sarrchri/6a13tt-timing-tool/6a13tt-timing-gear-tool-gt8-5mm.3mf

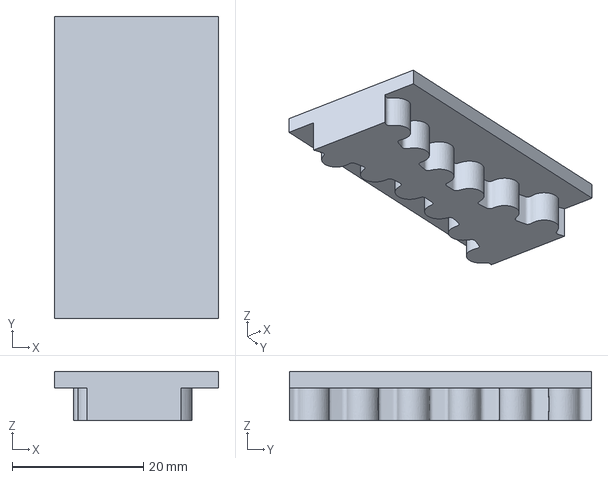
[picture p1: CAD file, 2026-09-26]
6a13tt-timing-gear-tool-gt8-5mm.3mf
25.0 x 46.0 x 7.50 mm
