sarrchri/6a13tt-timing-tool/6a13tt-timing-gears-and-tool-gt8.FCStd

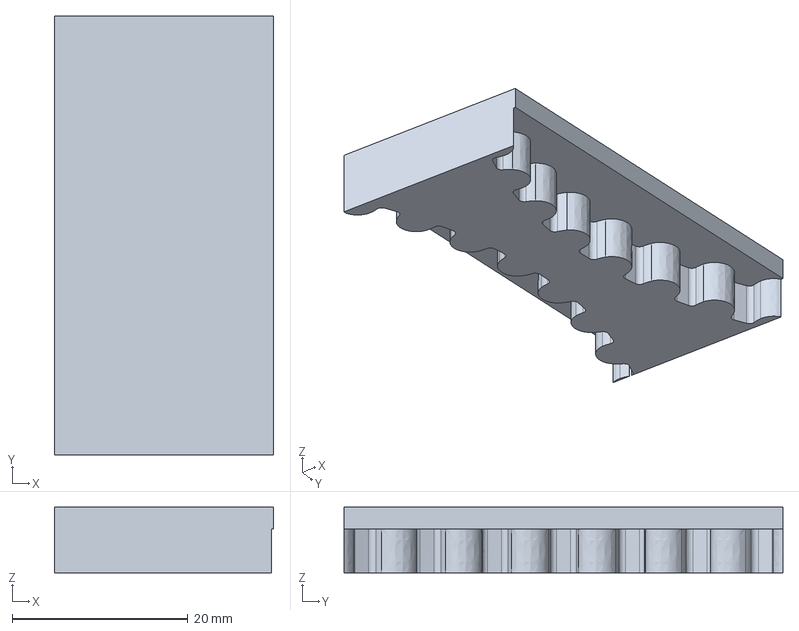
[picture p2: CAD file, 2026-09-22]
6a13tt-timing-gears-and-tool-gt8.FCStd
25.0 x 50.0 x 7.50 mm
