sarrchri/6a13tt-timing-tool/6a13tt-timing-gear-TimingGear-gt8.3mf

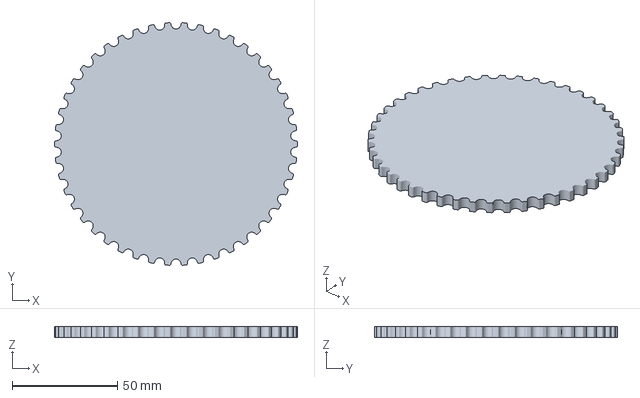
[picture p3: CAD file, 2026-09-20]
6a13tt-timing-gear-TimingGear-gt8.3mf
115.3 x 115.1 x 5.00 mm
