sarrchri/6a13tt-timing-tool/(list of files, cad)

Other CAD files:
6a13tt-timing-gears-and-tool-gt8-5mm.FCStd
6a13tt-timing-gear-tool-gt8-6mm.3mf
6a13tt-timing-gears-and-tool-gt8-6mm.FCStd
6a13tt-timing-gear-tool-gt8.3mf
6a13tt-timing-gear.FCStd
6a13tt-timing-gear-tool.3mf
6a13tt-timing-gear-TimingGear.3mf
