sarrchri/6a13tt-timing-tool/(commit log)

2026-09-19 Upload a rough model of a camshaft gear.
    Need to 3D-print this and compare, then make any adjustments and recompare.
    After the gear is correct, it's then time to make the gear wedge tool.
    [6a13tt-timing-gear.FCStd]
2026-09-19 Another update
    [6a13tt-timing-gear.FCStd]
2026-09-19 Made cross-section cut.
    [6a13tt-timing-gear.FCStd]
2026-09-19 Tool cutout made.
    [6a13tt-timing-gear-tool.3mf, 6a13tt-timing-gear.FCStd]
2026-09-20 Update. Added GT8 tooth profile variant.
    This seems to fit slightly better, but not fully.
    Apparently the tooth profile might a "YU" -profile, which I am not familiar with.
    [6a13tt-timing-gear-TimingGear-gt8.3mf, 6a13tt-timing-gear-tool-gt8.3mf, 6a13tt-timing-gears-and-tool-gt8.FCStd]
2026-09-20 Readjust gear distance for gt8 profile.
    New gear diameter 115.3mm, spacing 6.7mm.
    Will reprint and test fit again.
    [6a13tt-timing-gear-tool-gt8.3mf, 6a13tt-timing-gears-and-tool-gt8.FCStd]
2026-09-22 Set gap to 6mm and generate new project file.
    [6a13tt-timing-gear-tool-gt8-6mm.3mf, 6a13tt-timing-gears-and-tool-gt8-6mm.FCStd, 6a13tt-timing-gears-and-tool-gt8.FCStd]
2026-09-26 Adjust to 5mm width.
    [6a13tt-timing-gear-tool-gt8-5mm.3mf, 6a13tt-timing-gears-and-tool-gt8-5mm.FCStd]
